JoeParker18/Electric-Propeller-Thrust-Stand/docs/Electric_Thrust_Stand_Parts.docx

Electric Propeller Thrust Stand

Parts Status & Build Reference

Penn State Aerospace Portfolio Build | Updated June 2026

Project Overview

Same engineering exercise as the cold-gas thruster — characterize thrust, log data, compare against analytical predictions — but the propellant is a spinning propeller driven by a brushed DC motor instead of pressurized CO₂. This eliminates every high-pressure hazard (no 830 psi cartridge, no regulator, no burst risk) while reusing nearly all hardware already on hand.

Key addition over the gas build: closed-loop PID throttle control. Map thrust vs. PWM duty cycle open-loop, then close the loop so the Arduino actively holds a commanded thrust level. Results feed directly into the hybrid lander demonstrator concept (electric lift + cold-gas attitude control).

Parts Status at a Glance

✅ Section 1 (green) Already owned — no action needed.

📦 Section 2 (teal) Ordered or pending return — track delivery / initiate returns by July 15.

🛒 Section 3 (amber) Still to buy — frame hardware from Home Depot.

🖨️ Section 4 (blue) 3D-print in Fusion 360, submit to Maker Commons in PLA.

1. Already Own ✅

All arrived in your June 15 Amazon delivery. No re-purchase needed.

Component | Qty | Role in the thrust stand
Arduino Uno R3 + USB cable | 1 | Controller — generates PWM throttle signal, reads the load cell, and runs the PID loop.
5 kg load cell + HX711 amplifier | 2 sets | Thrust measurement. One set active; second is a spare or can measure reaction torque on a second axis.
IRF520 MOSFET driver module | 5 pcs | PWM speed control of the brushed motor. Only one needed; rest are spares.
1N4007 rectifier diode | 125 pcs | Flyback protection across motor terminals — prevents inductive spike from destroying the MOSFET.
10 kΩ resistor | 10 pcs | Gate pull-down on the MOSFET; optional voltage divider for crude voltage sensing.
Breadboard + jumper wire kit | 1 | Solderless prototyping of the driver and sensor circuit.
2020 aluminum extrusion, 300 mm | 4 pcs | Test-stand structural frame — base rails and upright to hold the motor arm and load cell.
12 V 2 A regulated power supply (with screw-terminal tip) | 1 | Motor power. The 2 A ceiling bounds motor current so the IRF520 runs without a heatsink. Use the green screw-terminal tip included with the supply — no barrel-jack adapter needed.

2. Ordered / Pending Return 📦

Parts you've ordered (arriving shortly) and two returns to initiate before July 15.

Part | Order status | Notes
JING RS-380 DC Motor, 12 V 10,000 RPM 2.3 mm round shaft (2-pack) | Ordered — arrives tomorrow | Plain bare shaft, no pinion gear. Run at 12 V for ~10,000 RPM. Second motor is a spare. Keep duty cycle low until you confirm current stays under 2 A with the prop loaded.
2.3 mm bullet / collet prop adapter (B09G3H2QXQ, 5-pack, 2.3 mm variant) | Ordered | Clamps the motor shaft rigidly; threaded stud holds the prop. Rigid mount gives cleaner thrust data than an O-ring prop saver. Select 2.3 mm at checkout — confirmed match to the JING motor shaft.
MECCANIXITY 6×4 propeller (4-pack with adapter rings) | Ordered | 2-blade nylon prop, 6-inch diameter. Adapter rings size the center hole to the bullet adapter stud. Pack of 4 gives spares for balancing experiments. Start at low throttle — drop to a 5-inch prop if the motor bogs or supply sags near 2 A.
CO₂ cartridges (CXWXC 88 g, 2-pack) | Return pending (eligible through July 15) | No longer needed — original cold-gas project pivoted to electric. Return for ~$19 refund.
AOMAG solenoid valve (2V025-06T, normally open) | Return pending (eligible through July 15) | Not used in the electric build — motor speed is controlled by the IRF520 MOSFET via PWM, no valve needed. Return for ~$13 refund, or set aside for a future pneumatics project.

3. Still to Buy 🛒

Only two remaining gaps — one essential, one optional.

Part still needed | Spec / why you need it | Est. cost
2020 frame hardware (corner brackets, T-nuts, M5 bolts) | Corner brackets join the extrusion rails at 90° — without them the frame can't hold shape under load. M5 bolts + T-nuts from Home Depot metric kit is fine. Verify brackets fit a 20 mm slot width (standard for 2020 extrusion). Corner brackets also available at Home Depot in the structural hardware aisle. | $8–15
Calibration weight (optional) | A known mass (100–500 g) to zero and scale the load cell. A stack of coins of known weight also works at no cost. | $0–8

Home Depot tip: Look in the metric bolt aisle for M5 hex-head bolts (10–16 mm length) and matching M5 hex nuts. For corner brackets, check the structural / project hardware aisle and confirm the bracket slot opening is 6 mm wide (standard 2020 T-slot width) before buying.

4. 3D-Printed Parts — Model in Fusion 360, Print at Maker Commons (PLA) 🖨️

Design and print these after the motor and load cell arrive so you can measure and verify dimensions before modeling.

Part to model & print | Purpose / design notes | Material
Motor mount | Holds the motor body at the free (moving) end of the load cell so thrust transfers cleanly into the sensor. Design around the JING motor body diameter (28 mm). Include bolt holes to match the motor's M2.5 end-plate holes, and a few-mm air gap or standoff between the motor face and the PLA to limit heat soak. | PLA Maker Commons 40–50% infill
Load-cell mounting plates (×2) | A fixed base plate (bolts to the 2020 frame) and a moving plate (bolts to the motor mount). The bar load cell sandwiches between them and bends under the thrust force. Keep the plate geometry symmetric so the cell bends cleanly in one axis only. | PLA Maker Commons 25–30% infill
Prop guard (recommended) | A simple open-sided fence around the prop arc. Keeps fingers and loose wires out of the spinning prop. Can be as simple as four vertical posts with a ring; does not need to be airtight. | PLA Maker Commons 20% infill
Electronics tray (optional) | Mounts the Arduino, breadboard, and MOSFET module neatly onto the 2020 frame rail. | PLA Maker Commons 20% infill

PLA print settings for the motor mount (most critical part): 40–50% infill, generous fillets at all bolt bosses, and a small air-gap or spacer between the motor body and the mount face to limit heat soak from the motor. Keep test runs to 1–2 minute bursts. Store all printed parts indoors — PLA softens near 55–60 °C and a warped mount drifts your thrust zero.

Prop guard — strongly recommended: Model a simple open-sided ring or cage around the prop arc before your first powered test. A 6-inch prop at 10,000 RPM is the primary safety hazard on this build.

5. Budget Summary

Line | Amount
Components already owned (June 15 delivery) | $0
Motor + adapter + prop (ordered) | ~$30
Frame hardware (Home Depot) | $8–15
3D-printed parts — PLA at Maker Commons | ~$2
CO₂ cartridge refund (return by July 15) | –$19
Solenoid valve refund (return by July 15) | –$13
Net out-of-pocket (after returns) | ≈ $8–15

6. How It Wires Together

Sensing: Load cell → HX711 → Arduino. HX711 DT and SCK connect to two Arduino digital pins; power from Arduino 5 V / GND.

Actuation: Arduino PWM pin → IRF520 module SIG input. 12 V supply feeds the motor through the MOSFET drain/source. Place one 1N4007 across the motor terminals, cathode (banded end) toward +12 V.

Grounding: Tie Arduino GND, IRF520 GND, and 12 V supply negative together. A shared common ground is required — without it the MOSFET won't switch reliably.

Power connection: Use the green screw-terminal tip included with your 12 V supply. Confirm output is 12 V and match the +/– polarity marked on the tip before wiring.

Control sequence: (1) Open-loop sweep: step PWM from 0–255, record thrust at each step in MATLAB, plot the thrust-vs-throttle curve. (2) Closed-loop PID: tune Kp/Ki/Kd so the Arduino holds a commanded thrust setpoint against disturbances.

7. Safety Notes

Primary hazard: A 6-inch prop at 10,000 RPM. Always print and install the prop guard before powered tests. Secure the stand to the bench, clear the prop arc, and wear eye protection.

Current monitoring: Ramp throttle slowly on first runs. If the 12 V supply sags or the motor bogs, you've hit the 2 A wall — reduce duty cycle or switch to a smaller prop.

Returns deadline: Both the CO₂ cartridges and the solenoid valve are eligible for return through July 15, 2026. Initiate the returns soon to avoid missing the window.

Penn State Aerospace Project | Joe | Page
