JoeParker18/Electric-Propeller-Thrust-Stand/cad/Corner Bracket.stl

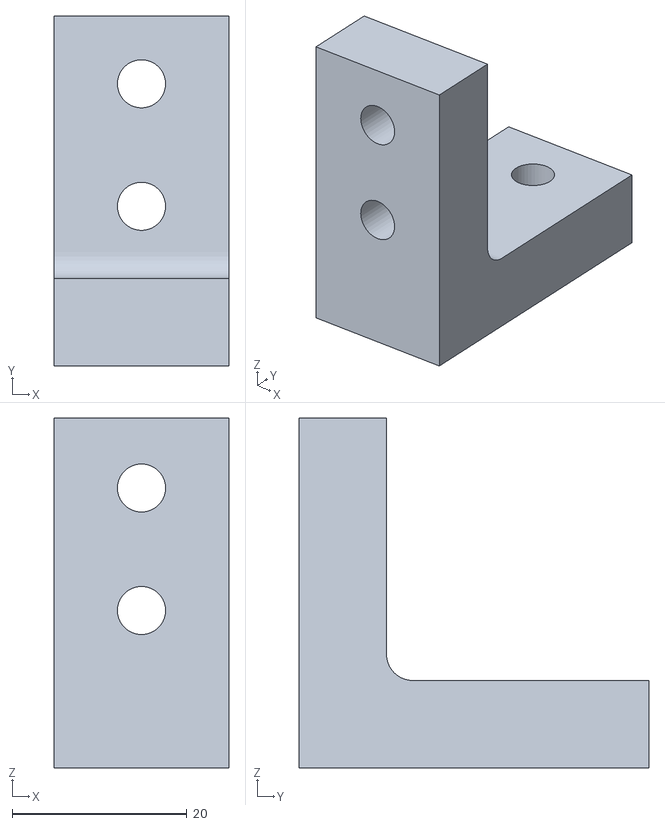
[picture p1: CAD file, 2026-10-26]
cad/Corner Bracket.stl
20.0 x 40.0 x 40.0
