JoeParker18/Electric-Propeller-Thrust-Stand/cad/e-prop fixed end.stl

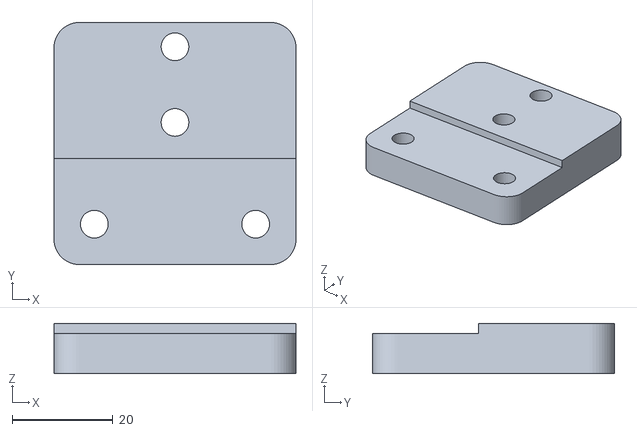
[picture p2: CAD file, 2026-10-26]
cad/e-prop fixed end.stl
48.0 x 48.0 x 10.0
