JoeParker18/Electric-Propeller-Thrust-Stand/cad/E-Prop Mount.stl

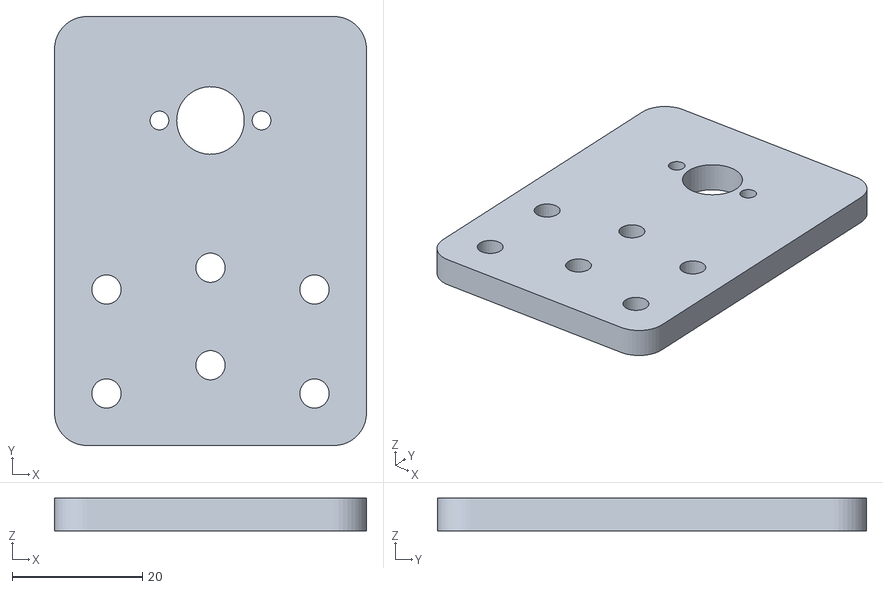
[picture p3: CAD file, 2026-10-26]
cad/E-Prop Mount.stl
48.0 x 66.0 x 5.00
