JoeParker18/Electric-Propeller-Thrust-Stand/cad/E-prop free end plate.stl

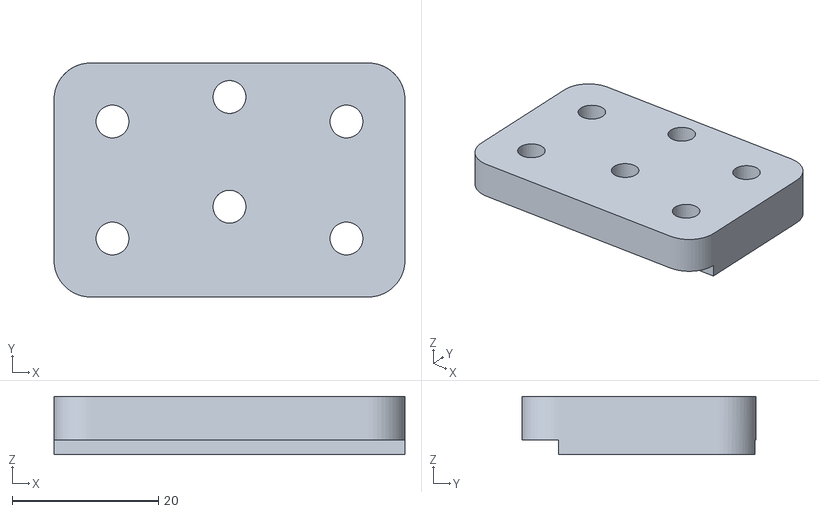
[picture p4: CAD file, 2026-10-26]
cad/E-prop free end plate.stl
48.0 x 32.0 x 8.00
